mx-town/Arduino-temp-ctrl/Schematic _TempCtrl.pdf

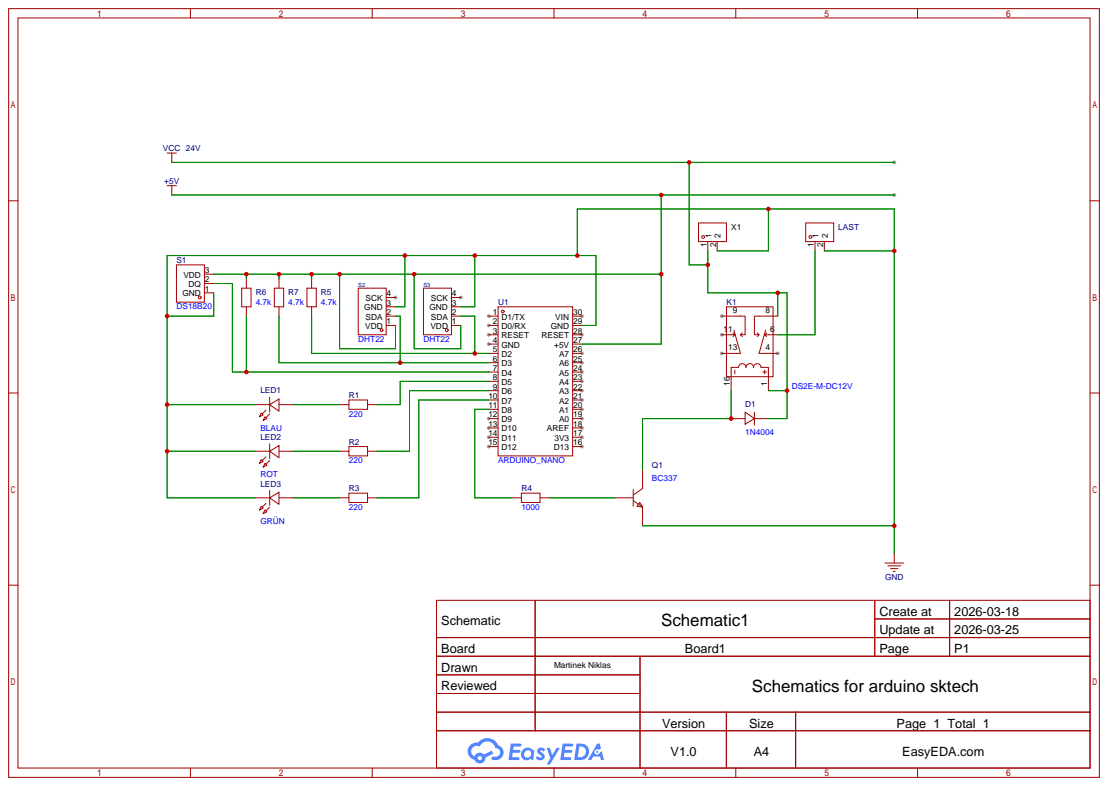
[picture p1: page 1]

Schematic | Schematic1 | Create at | 2026-03-18

Update at | 2026-03-25

Board | Board1 | Page | P1
Drawn | Martinek Niklas | Schematics for arduino sktech
Reviewed

Version | Size | Page 1 Total 1
V1.0 | A4 | EasyEDA.com
